rallyfanru/RPM_LED_HW/README.md

# RPM_LED_HW
Аппаратная часть проекта https://github.com/rallyfanru/RPM_LED  
Проект сделан в Kicad 5  
Требует исправления, список ошибок в changelog.txt
