rallyfanru/RPM_LED_HW/parts.xlsx

 |  |  |  |  | Итого: | 753.31
Обозначение | Элемент | Номинал | Корпус | Код | Ссылка | Цена
C11 | конденсатор | 100u | SMD D | 593D107X9010D2TE3 | https://spb.terraelectronica.ru/product/358908 | 24.60
C12 | конденсатор | 100u | SMD D | 593D107X9010D2TE3 | https://spb.terraelectronica.ru/product/358908 | 24.60
C10 | конденсатор | 1.5p | 0805 | CC0805CRNPO9BN1R5 | https://spb.terraelectronica.ru/product/1107359 | 1.30
C5 | конденсатор | 20p | 0805 | CC0805JRNPO9BN200 | https://spb.terraelectronica.ru/product/326950 | 1.30
C6 | конденсатор | 20p | 0805 | CC0805JRNPO9BN200 | https://spb.terraelectronica.ru/product/326950 | 1.30
C1 | конденсатор | 100n | 0805 | CC0805ZRY5V9BB104 | https://spb.terraelectronica.ru/product/360375 | 2.20
C2 | конденсатор | 100n | 0805 | CC0805ZRY5V9BB104 | https://spb.terraelectronica.ru/product/360375 | 2.20
C3 | конденсатор | 100n | 0805 | CC0805ZRY5V9BB104 | https://spb.terraelectronica.ru/product/360375 | 2.20
C8 | конденсатор | 100n | 0805 | CC0805ZRY5V9BB104 | https://spb.terraelectronica.ru/product/360375 | 2.20
C9 | конденсатор | 100n | 0805 | CC0805ZRY5V9BB104 | https://spb.terraelectronica.ru/product/360375 | 2.20
C7 | конденсатор | 4.7u | 1206 | CC1206KKX7R9BB475 | https://spb.terraelectronica.ru/product/1320438 | 29.20
C14 | конденсатор | 10u | 1206 | CL31B106KPHNNNE | https://spb.terraelectronica.ru/product/1641462 | 6.10
C15 | конденсатор | 4.7u | 1206 | GRM31CR71A475KA01L | https://spb.terraelectronica.ru/product/361734 | 8.70
D10 | сапрессор | 18B |  | 1.5KE18CA | https://www.chipdip.ru/product/1.5ke18ca | 16.00
D9 | Диод |  | SMB | STPS2L25U | https://spb.terraelectronica.ru/product/236375 | 8.80
L1 | индуктивность |  |  | IHLP2525CZER8R2M01 | https://spb.terraelectronica.ru/product/577217 | 36.90
L3 | LDO |  |  | NCP5501DT33RKG | https://spb.terraelectronica.ru/product/437019 | 24.80
R1 | резистор | 10K | 1206 | CR1206-JW-103ELF | https://spb.terraelectronica.ru/product/1628762 | 0.50
R2 | резистор | 60.4K | 0603 | RC0603FR-0760K4L | https://spb.terraelectronica.ru/product/871175 | 0.15
R3 | резистор | 187K | 0603 | RC0603FR-07187KL | https://spb.terraelectronica.ru/product/871017 | 0.42
R4 | резистор | 1K | 1206 | CR1206-JW-102ELF | https://spb.terraelectronica.ru/product/265324 | 0.62
R5 | резистор | 1K | 1206 | CR1206-JW-102ELF | https://spb.terraelectronica.ru/product/265324 | 0.62
U1 | STP16CP05 |  |  | STP16CP05MTR | https://spb.terraelectronica.ru/product/274946 | 71.50
U2 | STM32F042 |  |  | STM32F042K6T6 | https://spb.terraelectronica.ru/product/1334269 | 160.00
U3 | STP16CP05 |  |  | STP16CP05MTR | https://spb.terraelectronica.ru/product/274946 | 71.50
U4 | CAN |  |  | SN65HVD230 | https://spb.terraelectronica.ru/product/176199 | 145.00
U5 | dc-dc |  |  | ST1S14PHR | https://spb.terraelectronica.ru/product/674771 | 96.00
Y1 | Кварц |  |  | KX-3H 8.0 MHz | https://spb.terraelectronica.ru/product/31625 | 12.40
