rallyfanru/RPM_LED_HW/rpmled3.kicad_pcb

## KiCad design rpmled3.kicad_pcb (2018-12-20)

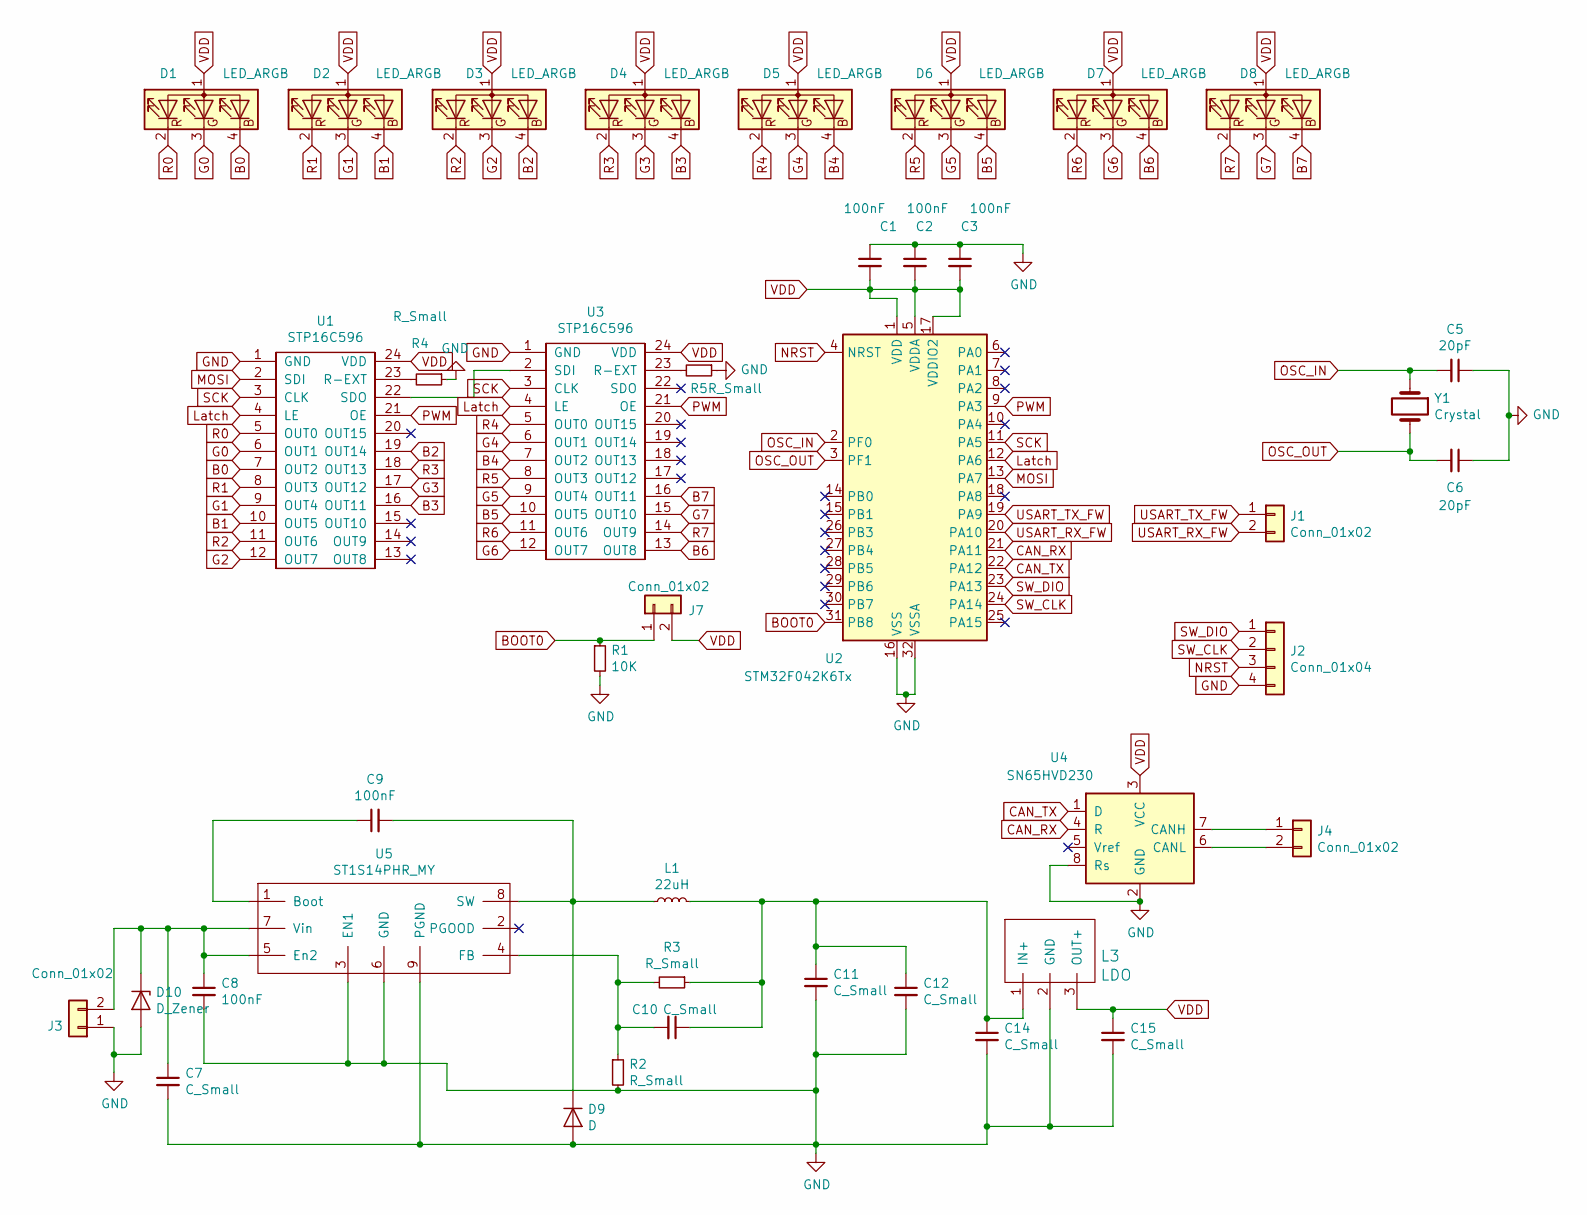
[picture p1: schematic rpmled3.sch]

Parts:
C1, C2, C3, C8, C9: 100nF; C_0805_2012Metric_Pad1.15x1.40mm_HandSolder
C5, C6: 20pF; C_0805_2012Metric_Pad1.15x1.40mm_HandSolder
C7, C14, C15: C_Small; C_1206_3216Metric_Pad1.42x1.75mm_HandSolder
C10: C_Small; C_0805_2012Metric_Pad1.15x1.40mm_HandSolder
C11, C12: C_Small; CP_EIA-7343-31_Kemet-D_Pad2.25x2.55mm_HandSolder
D1, D2, D3, D4, D5, D6, D7, D8: LED_ARGB; RGB_LEB_InLine
D9: D; D_SMB_Handsoldering
D10: D_Zener; D_DO-201AD_P12.70mm_Horizontal
J1, J3, J4, J7: Conn_01x02; PinHeader_1x02_P2.54mm_Vertical
J2: Conn_01x04; PinHeader_1x04_P2.54mm_Vertical
L1: 22uH; L_10.4x10.4_H4.8
L3: LDO; TO-252-3_TabPin2
R1: 10K; R_1206_3216Metric_Pad1.42x1.75mm_HandSolder
R2, R3: R_Small; R_0603_1608Metric_Pad1.05x0.95mm_HandSolder
R4, R5: R_Small; R_1206_HandSoldering
U1, U3: STP16C596; SOIC-24W_7.5x15.4mm_P1.27mm
U2: STM32F042K6Tx; LQFP-32_7x7mm_P0.8mm
U4: SN65HVD230; SOIC-8_3.9x4.9mm_P1.27mm
U5: ST1S14PHR_MY; SOIC-8-1EP_3.9x4.9mm_P1.27mm_EP2.35x2.35mm
Y1: Crystal; Crystal_HC49-4H_Vertical

Connections:
B0: D1.4 (BK), U1.7 (OUT2)
B1: D2.4 (BK), U1.10 (OUT5)
B2: D3.4 (BK), U1.19 (OUT14)
B3: D4.4 (BK), U1.16 (OUT11)
B4: D5.4 (BK), U3.7 (OUT2)
B5: D6.4 (BK), U3.10 (OUT5)
B6: D7.4 (BK), U3.13 (OUT8)
B7: D8.4 (BK), U3.16 (OUT11)
BOOT0: J7.1, R1.1, U2.31 (PB8)
CAN_RX: U2.21 (PA11), U4.4 (R)
CAN_TX: U2.22 (PA12), U4.1 (D)
G0: D1.3 (GK), U1.6 (OUT1)
G1: D2.3 (GK), U1.9 (OUT4)
G2: D3.3 (GK), U1.12 (OUT7)
G3: D4.3 (GK), U1.17 (OUT12)
G4: D5.3 (GK), U3.6 (OUT1)
G5: D6.3 (GK), U3.9 (OUT4)
G6: D7.3 (GK), U3.12 (OUT7)
G7: D8.3 (GK), U3.15 (OUT10)
GND: C1.1, C2.1, C3.1, C5.1, C6.1, C7.2, C8.2, C11.2, C12.2, C14.2, C15.2, D9.2 (A), D10.2 (A), J2.4, J3.1, L3.2 (GND), R1.2, R2.2, R4.1, R5.1, U1.1 (GND), U2.16 (VSS), U2.32 (VSSA), U3.1 (GND), U4.2 (GND), U4.8 (Rs), U5.3 (EN1), U5.6 (GND), U5.9 (PGND)
Latch: U1.4 (LE), U2.12 (PA6), U3.4 (LE)
MOSI: U1.2 (SDI), U2.13 (PA7)
NRST: J2.3, U2.4 (NRST)
unnamed: C7.1, C8.1, D10.1 (K), J3.2, U5.5 (En2), U5.7 (Vin)
unnamed: C9.1, U5.1 (Boot)
unnamed: C9.2, D9.1 (K), L1.1, U5.8 (SW)
unnamed: C10.1, C11.1, C12.1, C14.1, L1.2, L3.1 (IN+), R3.1
unnamed: C10.2, R2.1, R3.2, U5.4 (FB)
unnamed: J4.1, U4.7 (CANH)
unnamed: J4.2, U4.6 (CANL)
unnamed: R4.2, U1.23 (R-EXT)
unnamed: R5.2, U3.23 (R-EXT)
unnamed: U1.22 (SDO), U3.2 (SDI)
OSC_IN: C5.2, U2.2 (PF0), Y1.1
OSC_OUT: C6.2, U2.3 (PF1), Y1.2
PWM: U1.21 (OE), U2.9 (PA3), U3.21 (OE)
R0: D1.2 (RK), U1.5 (OUT0)
R1: D2.2 (RK), U1.8 (OUT3)
R2: D3.2 (RK), U1.11 (OUT6)
R3: D4.2 (RK), U1.18 (OUT13)
R4: D5.2 (RK), U3.5 (OUT0)
R5: D6.2 (RK), U3.8 (OUT3)
R6: D7.2 (RK), U3.11 (OUT6)
R7: D8.2 (RK), U3.14 (OUT9)
SCK: U1.3 (CLK), U2.11 (PA5), U3.3 (CLK)
SW_CLK: J2.2, U2.24 (PA14)
SW_DIO: J2.1, U2.23 (PA13)
USART_RX_FW: J1.2, U2.20 (PA10)
USART_TX_FW: J1.1, U2.19 (PA9)
VDD: C1.2, C2.2, C3.2, C15.1, D1.1 (A), D2.1 (A), D3.1 (A), D4.1 (A), D5.1 (A), D6.1 (A), D7.1 (A), D8.1 (A), J7.2, L3.3 (OUT+), U1.24 (VDD), U2.1 (VDD), U2.5 (VDDA), U2.17 (VDDIO2), U3.24 (VDD), U4.3 (VCC)

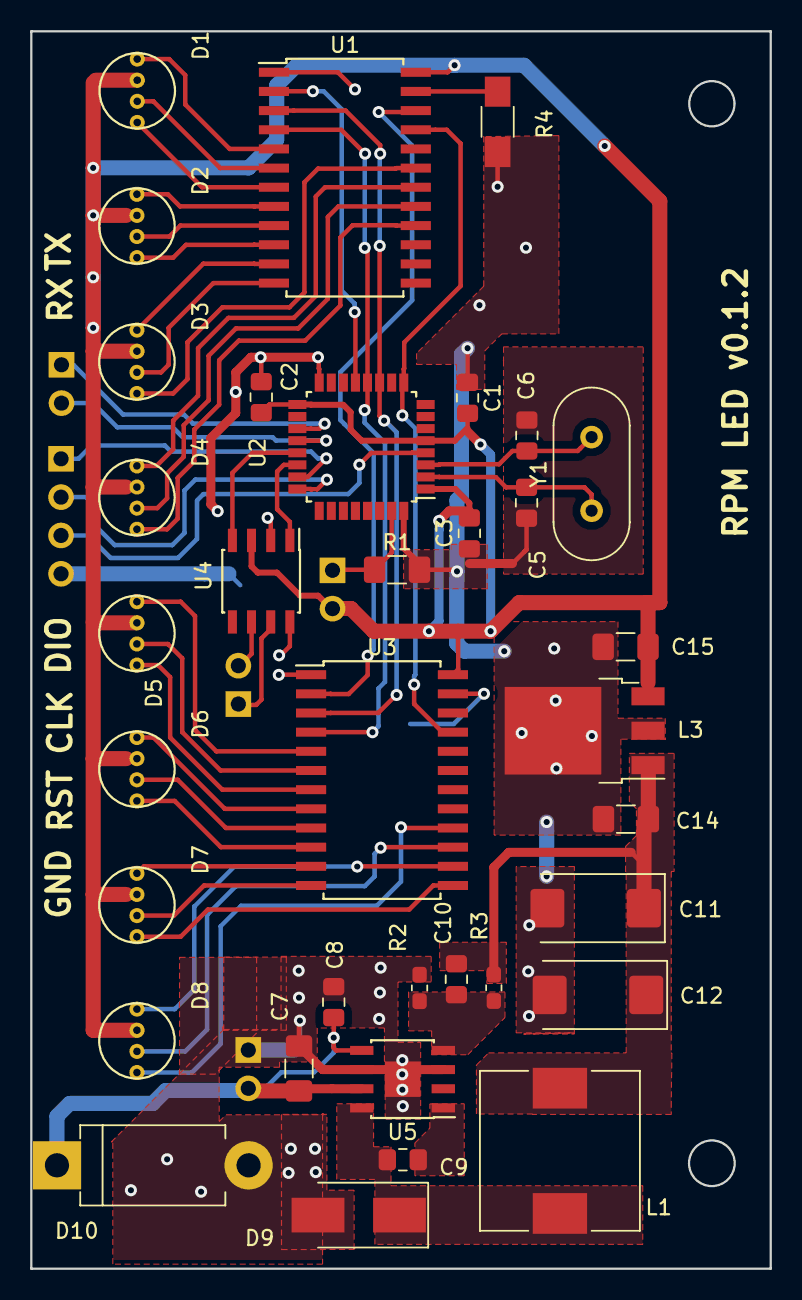
[picture p2: board rpmled3.kicad_pcb from above]

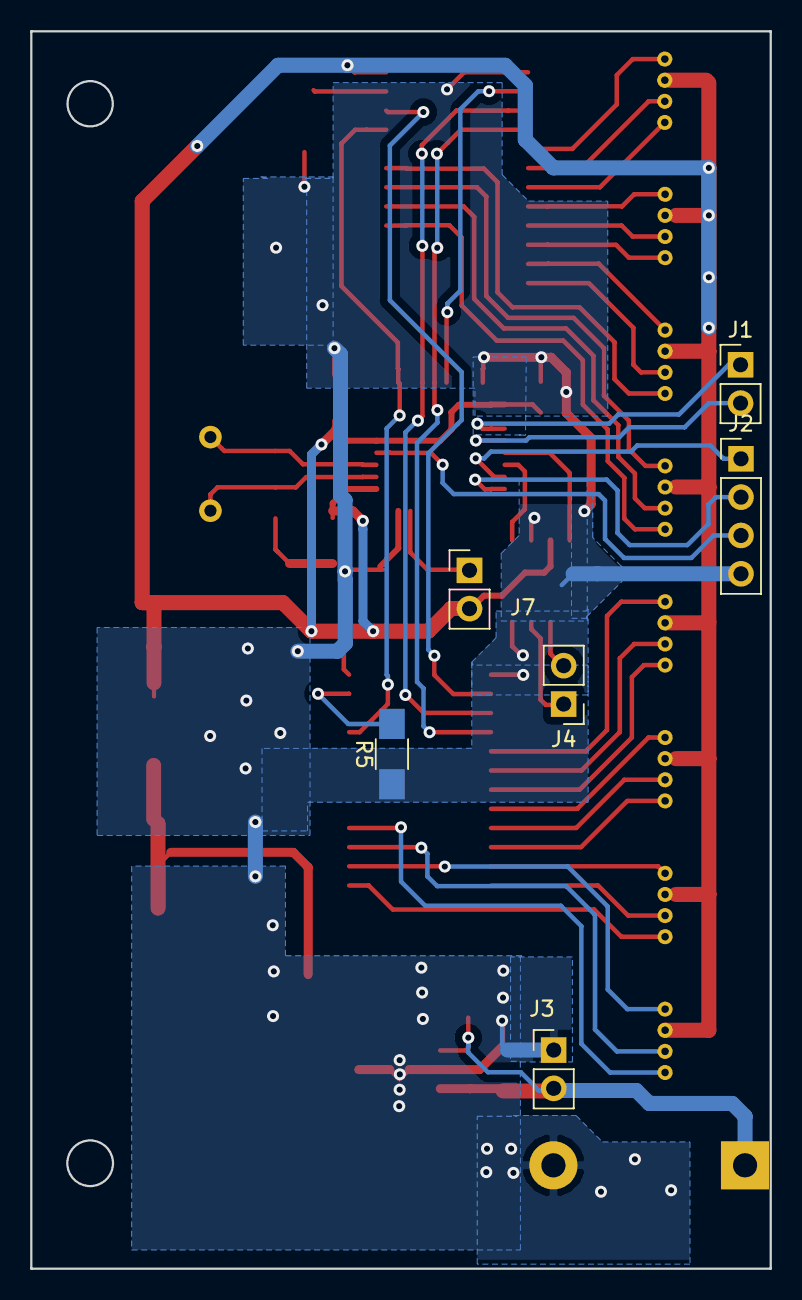
[picture p3: board rpmled3.kicad_pcb from below]

Board: 2 copper layers, 49.0 x 82.0 mm, 41 parts (6 on the bottom side), 50 nets.
