rallyfanru/RPM_LED_HW/changelog.txt

*****Надо исправить:******
- посадочные места светодиодов. Отверстия слишком маленькие, светодиод не влезает.
- питание: убрать LDO, изменить номинал резисторов s1st14 для получения 3.3В 
- подключаемое сопротивление 120 Ом для CAN
- маркировка разъемов с обратной стороны платы

v0.1.2
- Разъемы для подключения питания, can, и джампер boot перенесены на другую сторону
- Зона земли на обратной стороне продлена до входа питания

v0.1.1
- Исправил дорожки RX-TX и RST CLK, чуть пошире и ровнее
- Исправления на слое шелкографии в расположении обозначений

v0.1
Первый заказ платы
