rallyfanru/RPM_LED_HW/(commit log)

2018-12-20 Начальный коммит Версия 0.1, есть ошибки.
    [parts.xlsx, rpmled3.kicad_pcb, rpmled3.sch, s1st14.sch]
2018-12-20 Список ошибок
2018-12-20 Не стандартные компоненты перенесены в локальную библиотеку Исправления v0.1.2
    [rpmled3.kicad_pcb, rpmled3.sch]
